profhuster/mBFY22-LaserBeamProfile/README.md

# mBFY22-LaserBeamProfile
The laser beam profiler project.

[Main Project Guide](https://github.com/profhuster/mBFY22-LaserBeamProfile/blob/main/2022-mBFY-Laser_Beam_Profile_Project_22c.pdf)

[Back to mBFY22 Page](https://github.com/profhuster/mBFY22)
