profhuster/mBFY22-LaserBeamProfile/Code/README.md

# Code README File
The entire CircuitPython code is in the folder `ProfileBeam_22b`. 
Download and unzip this folder, then go into the folder. 
Drag and drop all of the contents to the CIRCUITPY drive. 
It has all of the library files needed to run the experiment.
When the code is running, the prompt is `>> `. 
Type `help` and a list of commands will be printed.

See the document _2022-mBFY-Laser-Beam-Profile-Project-22c.pdf_ 
for a sample data run.
