profhuster/mBFY22-LaserBeamProfile/Figures/2022-07-08-1331e_001.png

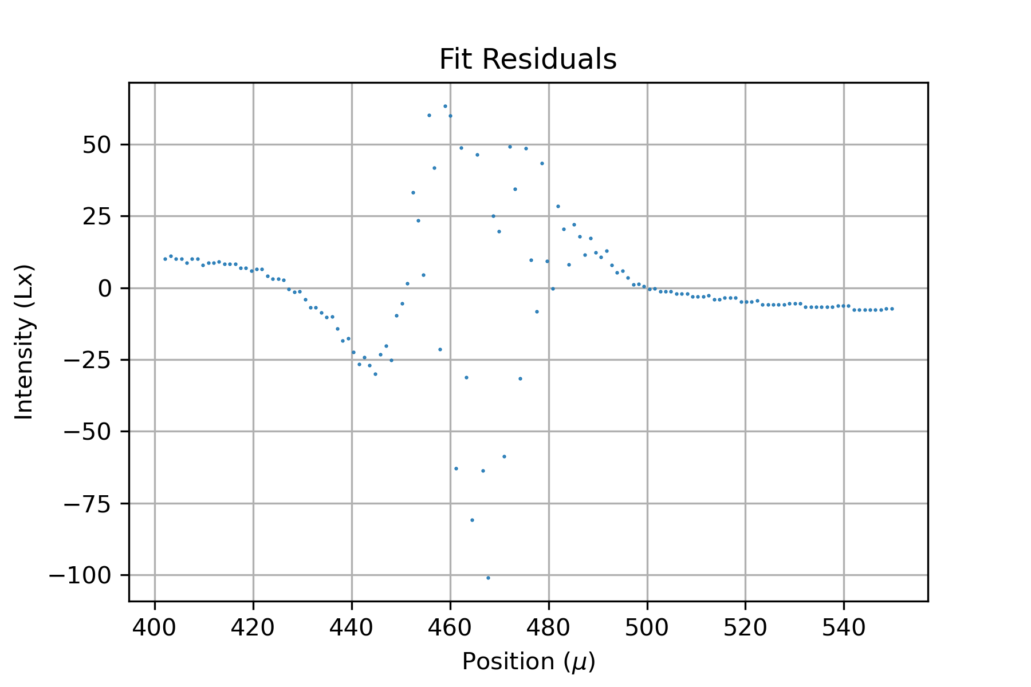
Figures/2022-07-08-1331e_001.png
