profhuster/mBFY22-LaserBeamProfile/Figures/20181112a_000.png

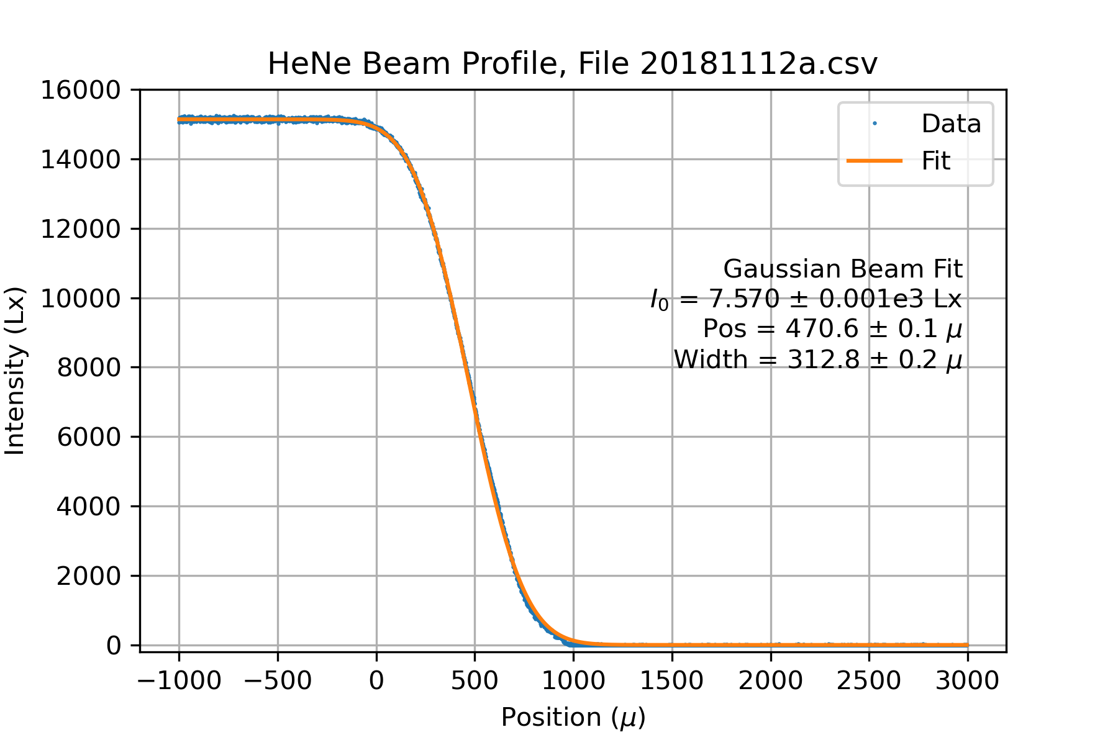
Figures/20181112a_000.png
