profhuster/mBFY22-LaserBeamProfile/Figures/20181112a_001.png

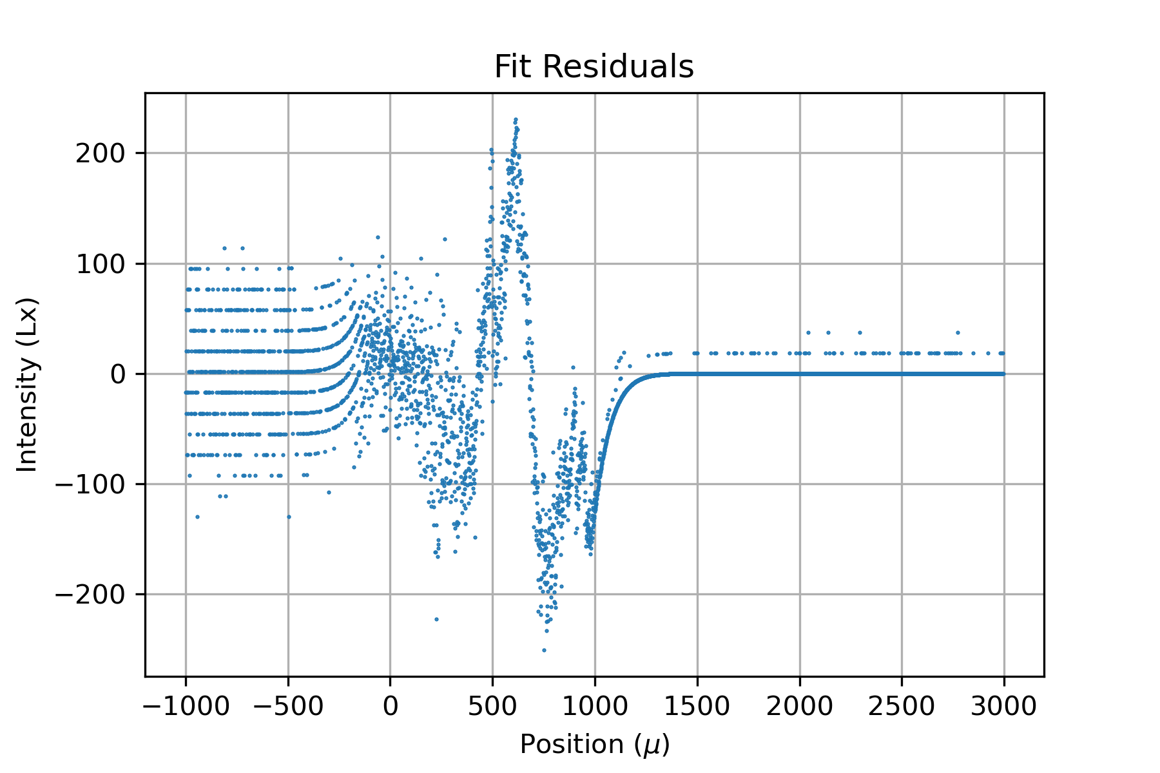
Figures/20181112a_001.png
