profhuster/mBFY22-LaserBeamProfile/Figures/Beam_Profile0-01.png

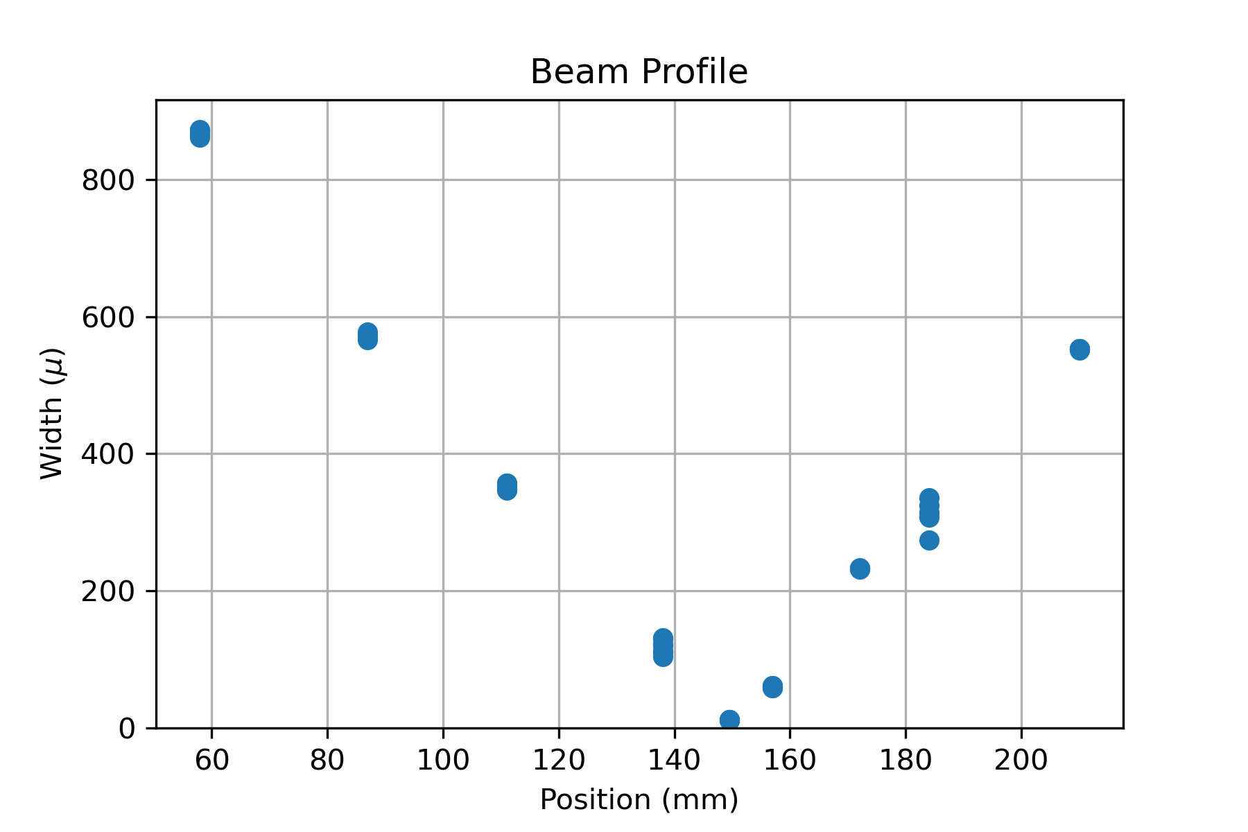
Figures/Beam_Profile0-01.png
