profhuster/mBFY22-LaserBeamProfile/Figures/Beam_Profile0-02.png

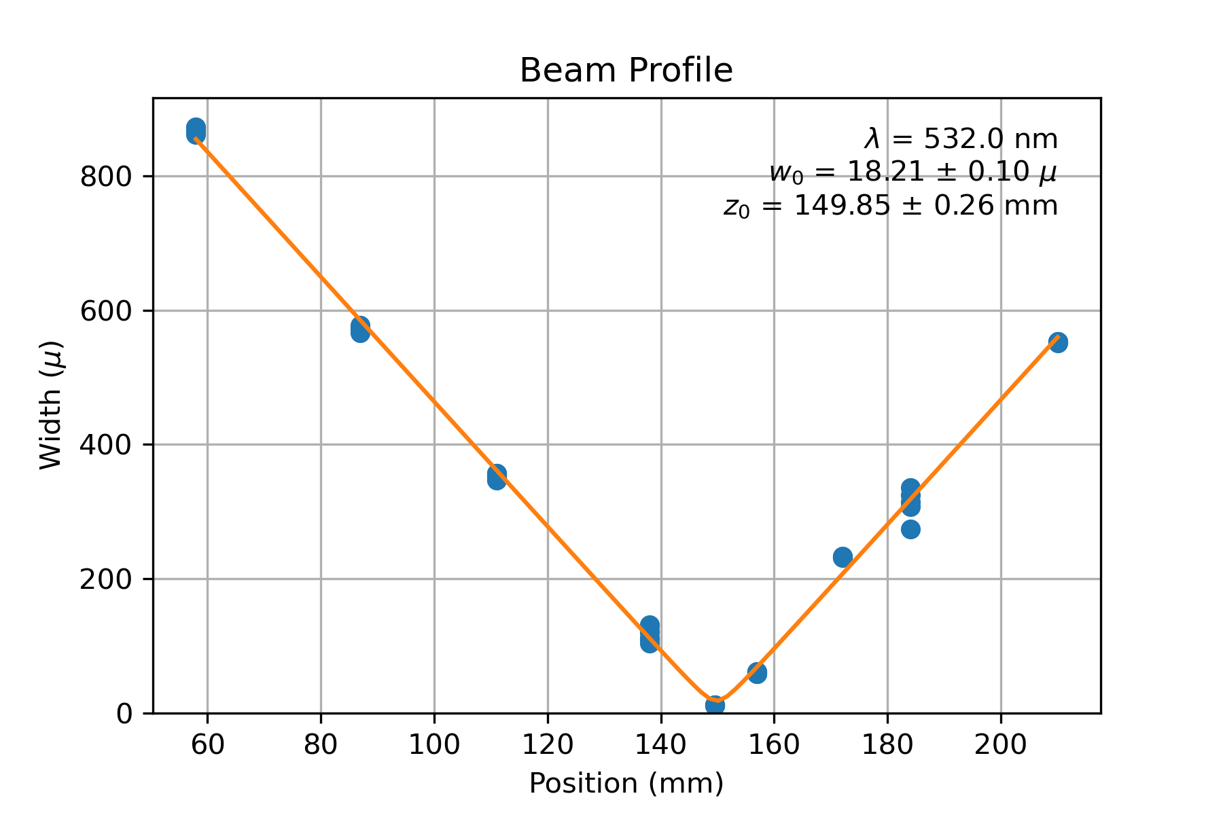
Figures/Beam_Profile0-02.png
