profhuster/mBFY22-LaserBeamProfile/3D Printing Files/Drive_Knobs_22a.stl

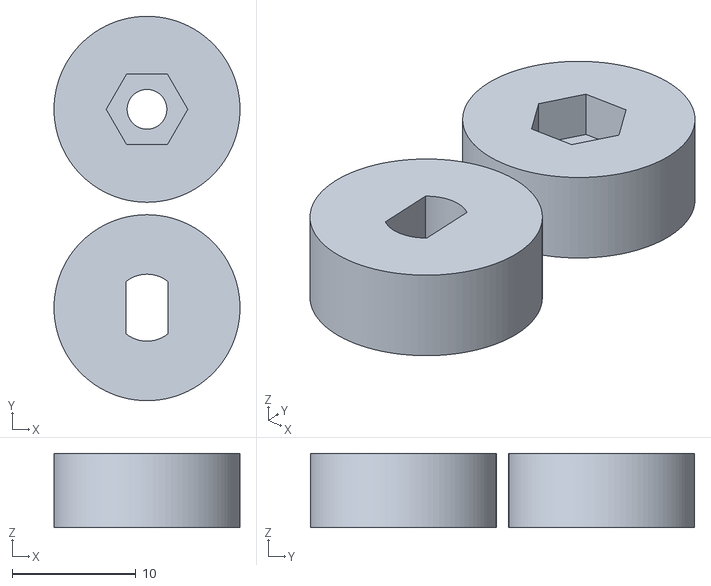
[picture p31: CAD file, 2022-06-26]
3D Printing Files/Drive_Knobs_22a.stl
15.0 x 31.0 x 6.00
