profhuster/mBFY22-LaserBeamProfile/3D Printing Files/MotorizedPrecisionTranslationStage 22b.stl

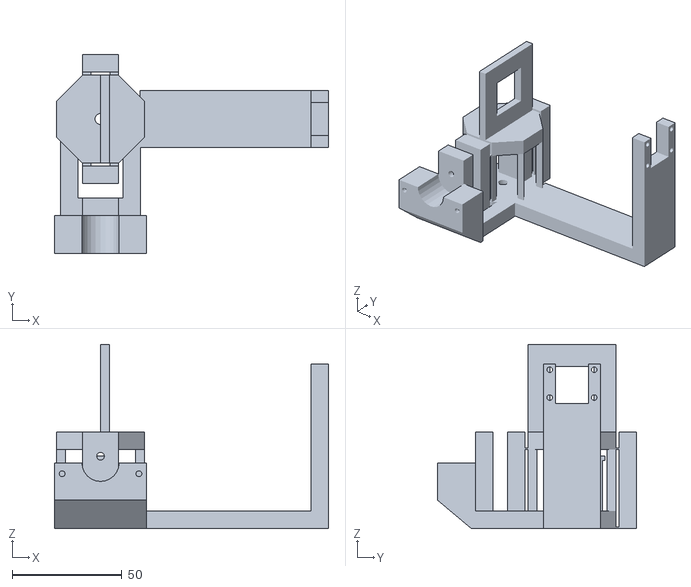
[picture p32: CAD file, 2022-06-21]
3D Printing Files/MotorizedPrecisionTranslationStage 22b.stl
125.0 x 90.9 x 84.0
