profhuster/mBFY22-LaserBeamProfile/3D Printing Files/S2Mini_Stepper_22a-both.stl

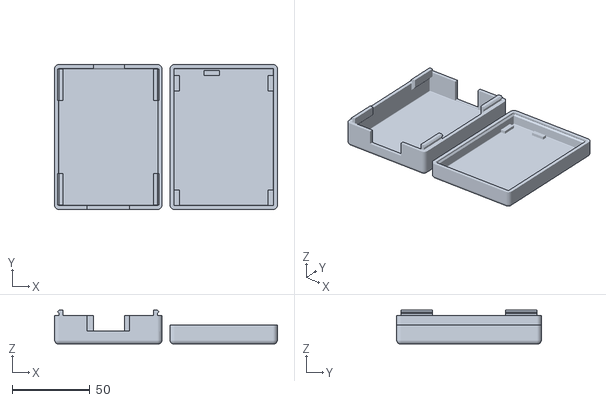
[picture p33: CAD file, 2022-06-17]
3D Printing Files/S2Mini_Stepper_22a-both.stl
143.0 x 93.0 x 21.5
