profhuster/mBFY22-LaserBeamProfile/Data/testData.csv

# z(m) | w(m)
0.0 | 0.0002830537108873668
0.05 | 9.936009889601692e-05
0.1 | 0.00010658199896640352
0.15 | 0.00034375145429706546
0.2 | 0.00048815044759809386
