profhuster/mBFY22-LaserBeamProfile/Data/testData.png

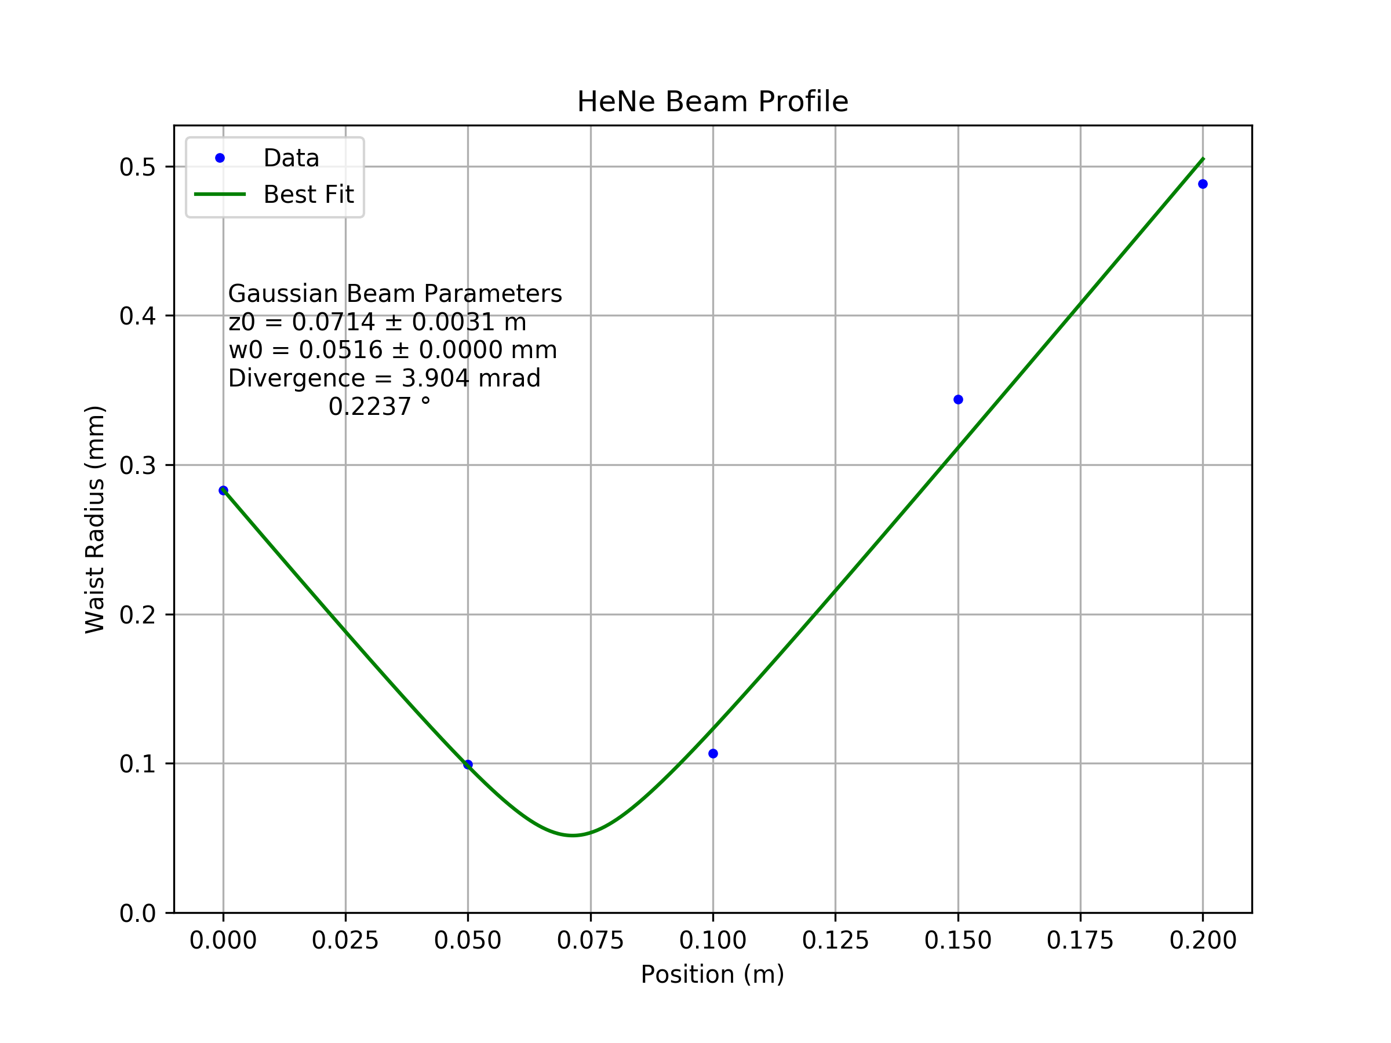
Data/testData.png
